Kraemii/catlamp/catlamp.kicad_pcb

## KiCad design catlamp.kicad_pcb (2026-09-23)

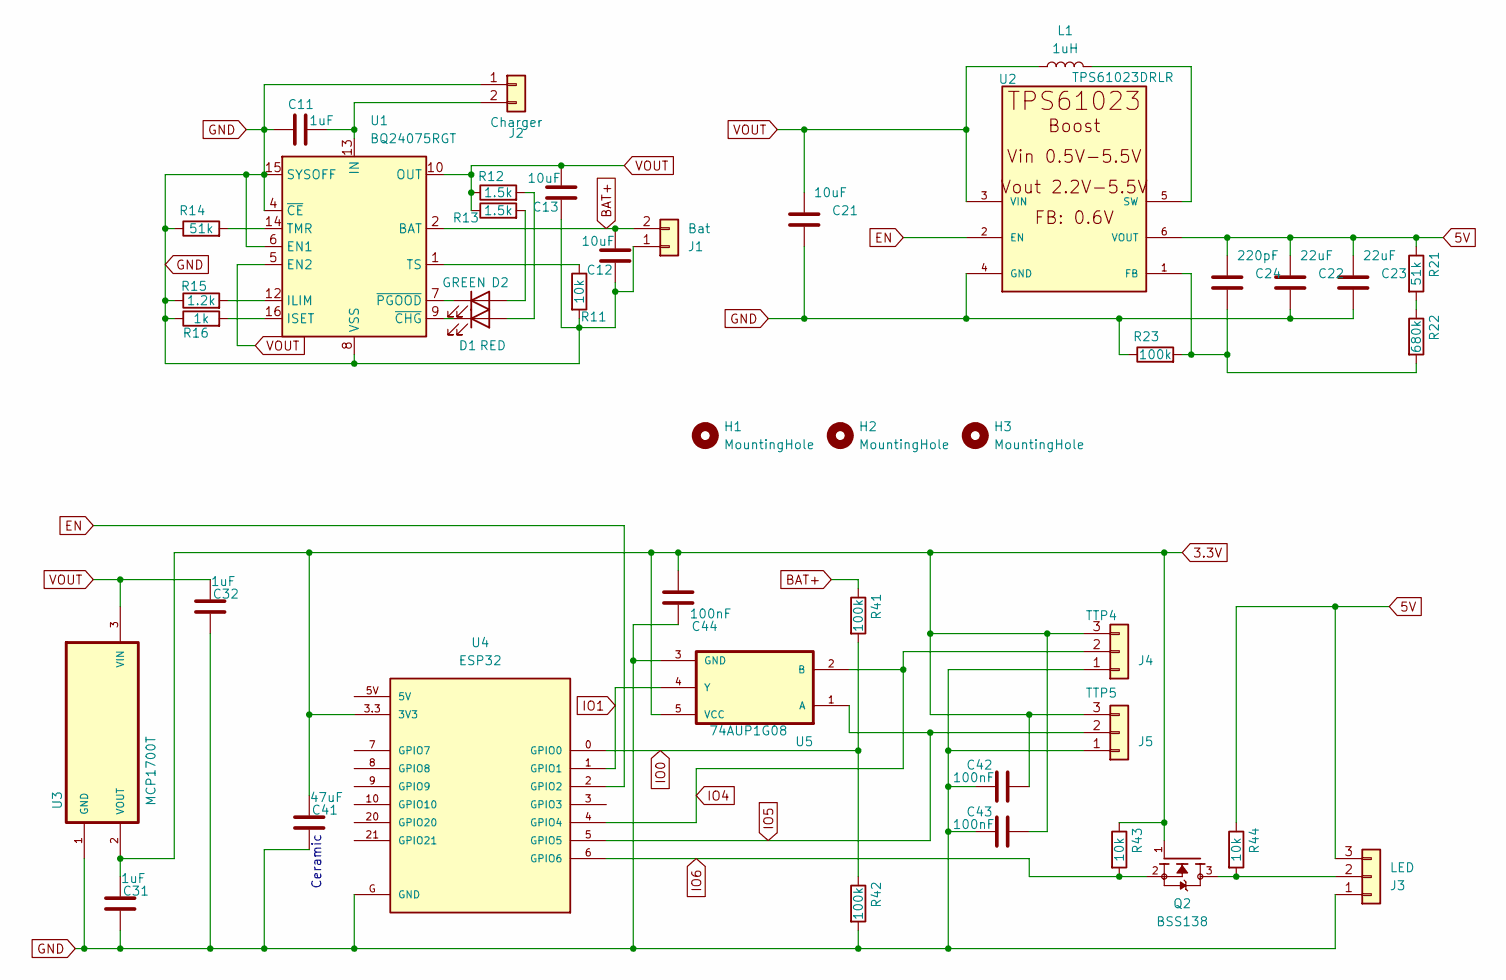
[picture p1: schematic catlamp.kicad_sch]

Parts:
C11, C31, C32: 1uF; C_0805_2012Metric_Pad1.18x1.45mm_HandSolder
C12, C13, C21: 10uF; C_0805_2012Metric_Pad1.18x1.45mm_HandSolder
C22, C23: 22uF; C_0805_2012Metric_Pad1.18x1.45mm_HandSolder
C24: 220pF; C_0805_2012Metric_Pad1.18x1.45mm_HandSolder
C41: 47uF; C_0805_2012Metric_Pad1.18x1.45mm_HandSolder
C42, C43, C44: 100nF; C_0805_2012Metric_Pad1.18x1.45mm_HandSolder
D1: RED; LED_0805_2012Metric_Pad1.15x1.40mm_HandSolder
D2: GREEN; LED_0805_2012Metric_Pad1.15x1.40mm_HandSolder
H1, H2, H3: MountingHole; MountingHole_2.2mm_M2
J1: Bat; PinHeader_1x02_P2.54mm_Vertical
J2: Charger; PinHeader_1x02_P2.54mm_Vertical
J3: LED; JST_PH_B3B-PH-K_1x03_P2.00mm_Vertical
J4: TTP4; JST_PH_B3B-PH-K_1x03_P2.00mm_Vertical
J5: TTP5; JST_PH_B3B-PH-K_1x03_P2.00mm_Vertical
L1: 1uH; L_APV_APH0630
Q2: BSS138; SOT-23_Handsoldering; PARTREV 30 Jan 2018
R11, R43, R44: 10k; R_0805_2012Metric_Pad1.20x1.40mm_HandSolder
R12, R13: 1.5k; R_0805_2012Metric_Pad1.20x1.40mm_HandSolder
R14, R21: 51k; R_0805_2012Metric_Pad1.20x1.40mm_HandSolder
R15: 1.2k; R_0805_2012Metric_Pad1.20x1.40mm_HandSolder
R16: 1k; R_0805_2012Metric_Pad1.20x1.40mm_HandSolder
R22: 680k; R_0805_2012Metric_Pad1.20x1.40mm_HandSolder
R23, R41, R42: 100k; R_0805_2012Metric_Pad1.20x1.40mm_HandSolder
U1: BQ24075RGT; VQFN-16-1EP_3x3mm_P0.5mm_EP1.6x1.6mm
U2: TPS61023DRLR; SOT563-ORI
U3: MCP1700T; SOT-23_Handsoldering
U4: ESP32; MODULE_ESP32-C3_SUPERMINI
U5: 74AUP1G08; SOT-23-5_HandSoldering

Connections:
3.3V: C31.1, C41.1, C42.2, C43.2, C44.2, J4.3, J5.3, Q2.1, R43.1, U3.2 (VOUT), U4.3.3 (3V3), U5.5 (VCC)
5V: C22.1, C23.1, C24.1, J3.3, R21.1, R44.1, U2.6 (VOUT)
BAT+: C12.2, J1.2, R41.1, U1.2 (BAT), U1.3 (BAT)
EN: U2.2 (EN), U4.2 (GPIO2)
GND: C11.1, C12.1, C13.1, C21.2, C22.2, C23.2, C31.2, C32.2, C41.2, C42.1, C43.1, C44.1, J1.1, J2.1, J3.1, J4.1, J5.1, R11.2, R14.1, R15.1, R16.1, R23.1, R42.2, U1.4 (~CE), U1.6 (EN1), U1.8 (VSS), U1.15 (SYSOFF), U1.17 (VSS), U2.4 (GND), U3.1 (GND), U4.G (GND), U5.3 (GND)
IO0: R41.2, R42.1, U4.0 (GPIO0)
IO1: U4.1 (GPIO1), U5.4 (Y)
IO4: J4.2, U4.4 (GPIO4), U5.2 (B)
IO5: J5.2, U4.5 (GPIO5), U5.1 (A)
IO6: Q2.2, R43.2, U4.6 (GPIO6)
unnamed: D1.2 (A), R12.2
unnamed: D1.1 (K), U1.9 (~CHG)
unnamed: D2.2 (A), R13.2
unnamed: D2.1 (K), U1.7 (~PGOOD)
unnamed: C11.2, J2.2, U1.13 (IN)
unnamed: J3.2, Q2.3, R44.2
unnamed: R21.2, R22.1
unnamed: R15.2, U1.12 (ILIM)
unnamed: R16.2, U1.16 (ISET)
unnamed: R14.2, U1.14 (TMR)
unnamed: R11.1, U1.1 (TS)
unnamed: C24.2, R22.2, R23.2, U2.1 (FB)
unnamed: L1.2, U2.5 (SW)
VOUT: C13.2, C21.1, C32.1, L1.1, R12.1, R13.1, U1.5 (EN2), U1.10 (OUT), U1.11 (OUT), U2.3 (VIN), U3.3 (VIN)

Notes on the sheet:
Ceramic

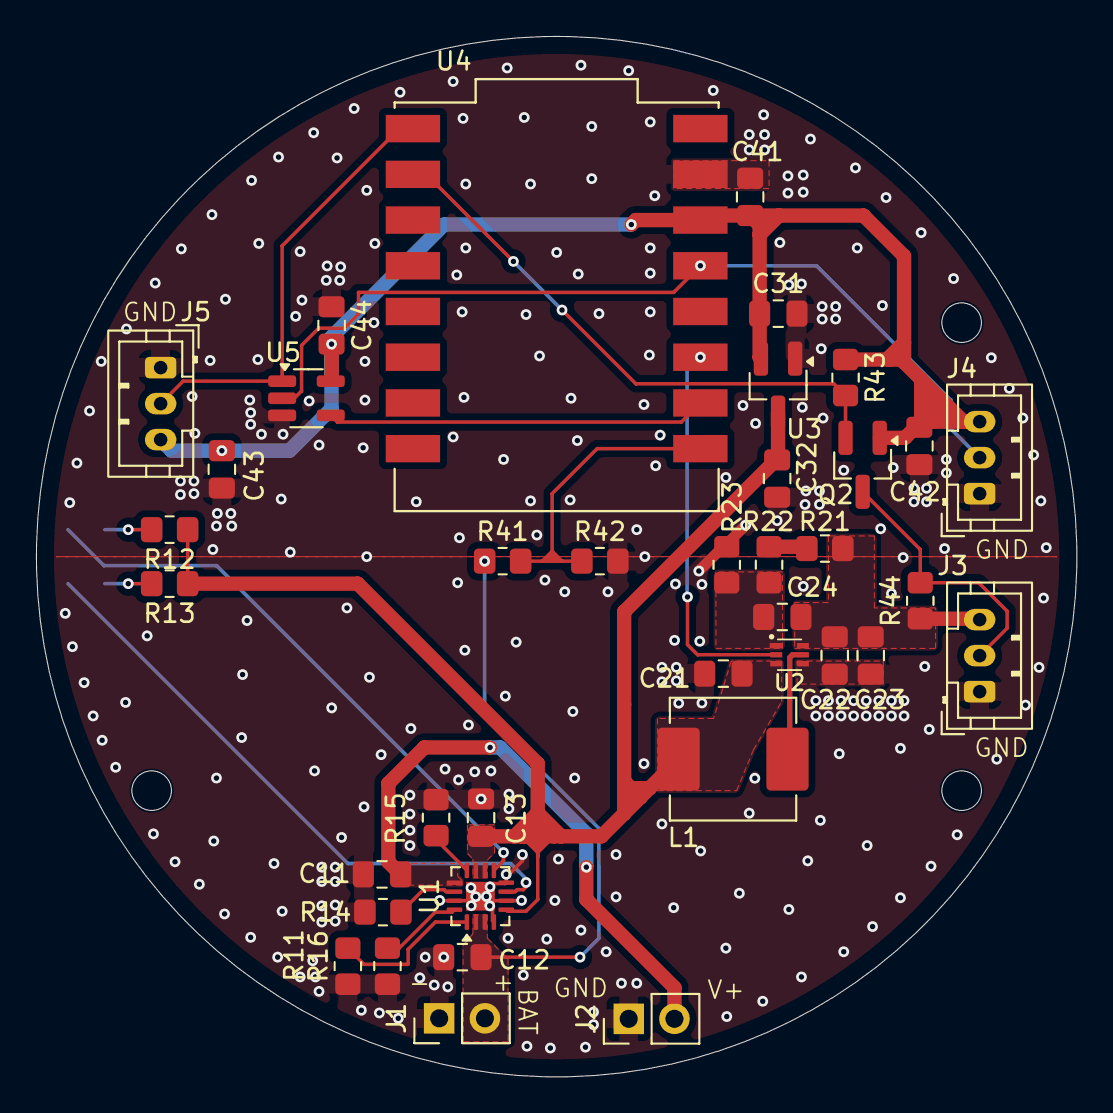
[picture p2: board catlamp.kicad_pcb from above]

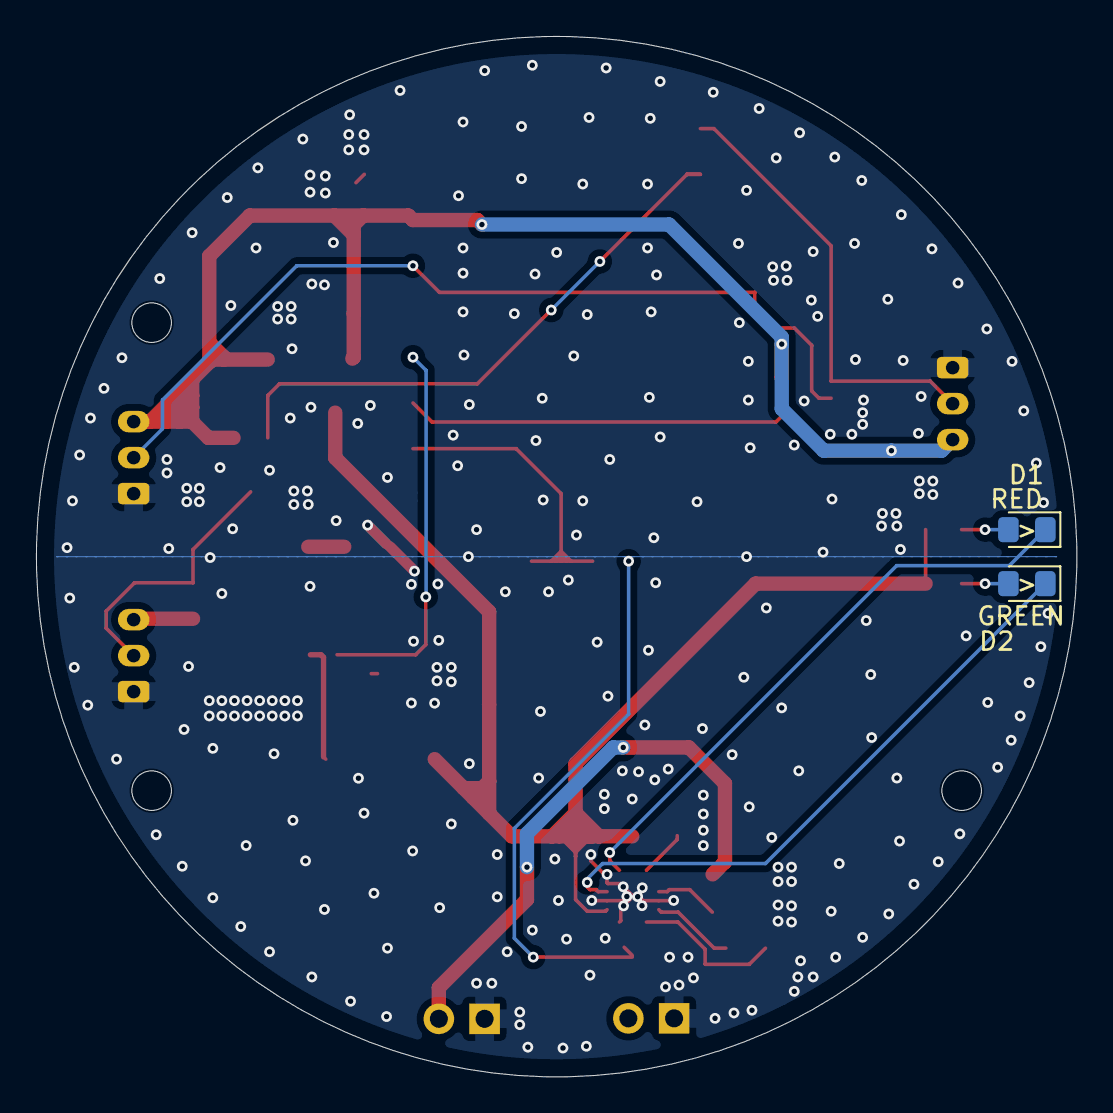
[picture p3: board catlamp.kicad_pcb from below]

Board: 2 copper layers, 57.8 x 57.8 mm, 46 parts (2 on the bottom side), 24 nets.

Other parts of the board:
H1#2: MountingHole; MountingHole_2.2mm_M2
H2#2, H3#2: Conn_01x01_MountingPin; MountingHole_2.2mm_M2
